Caiodesiderio/alimentador-automatico-iot/analise/dados/feeding_events_sintetico.csv

id | device_id | occurred_at | trigger | grams_target | grams | bowl_grams_after | consumed_grams | consumed | settled_at | source
2119b44b-8293-5f26-ab32-a91163551dea | esp32-01 | 2026-07-01T06:59:36-04:00 | scheduled | 120.00 | 123.25 | 128.45 | 113.16 | true | 2026-07-01T08:19:36-04:00 | synthetic
595a39f1-4a1b-533a-b577-42b654496da2 | esp32-01 | 2026-07-01T12:24:24-04:00 | scheduled | 100.00 | 97.18 | 112.47 | 96.46 | true | 2026-07-01T14:30:24-04:00 | synthetic
aa2978e4-04d1-55e3-a7a4-b0cdbde9157c | esp32-01 | 2026-07-01T19:00:52-04:00 | scheduled | 140.00 | 139.59 | 155.60 | 130.30 | true | 2026-07-01T21:00:52-04:00 | synthetic
74f18e98-9d06-520a-b9d1-636597ef695c | esp32-01 | 2026-07-02T07:08:23-04:00 | scheduled | 120.00 | 119.97 | 125.34 | 112.13 | true | 2026-07-02T10:06:23-04:00 | synthetic
09b205e2-957e-5864-863e-ffcf24e30b60 | esp32-01 | 2026-07-02T12:33:05-04:00 | scheduled | 100.00 | 91.62 | 104.83 | 91.19 | true | 2026-07-02T14:01:05-04:00 | synthetic
d6cf3ef1-554d-580e-a0da-06cec6c406da | esp32-01 | 2026-07-02T19:09:48-04:00 | scheduled | 140.00 | 130.28 | 143.92 | 120.74 | true | 2026-07-02T21:58:48-04:00 | synthetic
efc341da-9fb2-5f48-97c1-f76bb44f8a99 | esp32-01 | 2026-07-03T06:56:33-04:00 | scheduled | 120.00 | 124.92 | 131.04 | 112.90 | true | 2026-07-03T09:54:33-04:00 | synthetic
261908b0-164b-5837-b053-8a61d54749e3 | esp32-01 | 2026-07-03T12:37:30-04:00 | scheduled | 100.00 | 92.88 | 111.02 | 88.77 | true | 2026-07-03T14:18:30-04:00 | synthetic
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
6c1deb7b-74bd-5414-903d-f19bbfae72fc | esp32-01 | 2026-09-28T18:52:49-04:00 | scheduled | 140.00 | 143.12 | 161.89 | 137.30 | true | 2026-09-28T20:14:49-04:00 | synthetic
