Caiodesiderio/alimentador-automatico-iot/analise/resultados/consumo_diario.csv

data | consumido | liberado | refeicoes | nao_consumidas | z | z_robusto
2026-07-01 | 339.92 | 360.02 | 3 | 0 | 0.15101467552519612 | -0.23379408212559877
2026-07-02 | 324.06 | 341.87 | 3 | 0 | -0.1261060390658755 | -1.525771135265692
2026-07-03 | 329.08 | 353.03 | 3 | 0 | -0.03839191628862624 | -1.1168351449275307
2026-07-04 | 343.3 | 364.12 | 3 | 0 | 0.21007318847083423 | 0.0415452898550762
2026-07-05 | 340.58 | 356.36 | 3 | 0 | 0.16254681118913678 | -0.18002958937197838
2026-07-06 | 344.32 | 359.83 | 3 | 0 | 0.22789557995147028 | 0.12463586956521935
2026-07-07 | 353.59 | 361.82 | 3 | 0 | 0.3898696672313711 | 0.87978260869565
2026-07-08 | 323.07 | 347.11 | 3 | 0 | -0.14340424256178744 | -1.6064178743961273
2026-07-09 | 347.0 | 358.03 | 3 | 0 | 0.27472303992020125 | 0.3429522946859921
2026-07-10 | 116.06 | 352.37 | 3 | 0 | -3.7604760664897627 | -18.469732487922634
2026-07-11 | 351.12 | 359.17 | 3 | 0 | 0.34671152315571296 | 0.6785730676328512
2026-07-12 | 375.45 | 400.59 | 4 | 0 | 0.7718279787673625 | 2.6605277777777703
2026-07-13 | 387.02 | 400.77 | 4 | 0 | 0.9739898115428162 | 3.6030356280193123
2026-07-14 | 340.8 | 352.92 | 3 | 0 | 0.16639085641045095 | -0.16210809178743515
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
